willblev/SmokeyTheBarrel/(threads)

Thread 1 (2018-02-23):

Update on your smoker controller

SouthernAtHeart, 2018-02-23:
Hi, I’m wondering how this project is working out for you after 6 months. I’m working on making a similar project and was wondering if the Wemos wifi is working well for you. Thanks.

willblev, 2018-02-23:
It's working out swell! The only things I have changed were some snippets
of code to correct for some of the temperature probes which were giving low
readings, and adjusting the PID.

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

willblev, 2018-02-23:
Most likely it is not, but I will update it soon :-)

On Fri, Feb 23, 2018 at 5:22 PM, SouthernAtHeart <notifications@github.com>
wrote:

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

SouthernAtHeart, 2018-05-23:
Have you been able to tweak your code some?  Could you post your latest code with improved PID control. Thanks!

willblev, 2018-05-27:
Here's a fairly detailed explanation behind the [PID magic](https://www.controleng.com/single-article/understanding-pid-control-and-loop-tuning-fundamentals/61530560e8cf5044c7291bda7e44b655.html). As far as I understand, the algorithm will eventually sort itself out, but starting with the right parameters will get the smoker to your target temp faster (and keep it there). Let me know if you end up posting the PCB!

SouthernAtHeart, 2018-06-02:
Got my board in, but I’ve been tied up with other things.  I will send you some photos of my project when I get it done.
Later,
Charlie

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

willblev, 2018-09-10:
Hope your smoker is now up and running smoothly! I will update this repo soon to include some code which protects against undesired ATC behavior which could happen if any of the temperature probes stop working in the middle of a smoke. I'm going to close this issue, but feel free to contact me about any future questions!

Closed 2018-09-10.

Thread 2 (2018-08-15):

Fan selection

Sensornoob, 2018-08-15:
Hi mate. This looks amazing and thought I’d give it a go.

I have most of it working and ready to attach to my drum for testing/tuning. The only thing holding up the process is that I can’t manage to shut the fan off completely, which could be a large problem once on the drum.

I have tried a bunch of duty cycle values and my fan appears to run at 100% with 0 duty cycle and slowest at 255, then faster again as it increases from there up to 1000, but at no point shuts off.

Did you happen to come across this at all?
I’m assuming now that the fan I purchased can not be shut down via pwm. Would you be able to share the model number of the fan you used in you set up please?

Thanks for sharing your awesome project.

willblev, 2018-08-15:
Hi!
Glad to hear your build is going well otherwise! I did run in to the exact same problem. 4 wire fans that can be controlled via PWM have an ESC board inside them- this circuit detects the input and decides how fast the fan should go, then looks at the tachometer to see how fast it is turning. Depending on the specs of your particular fan model, if it doesn't detect an input that falls within the expected range, it may ramp up to full speed. From what I remember, my fan (a Dell KH302 harvested from an old server rack)
did the same thing. I think I got my hands on the spec sheet for this model, and found a chart that showed the relationship between input duty cycle/fan RPM.

If you're unable to dig up a specification sheet for your fan model, I can think of 2 possible solutions: 1. Use another GPIO coupled with a hefty transistor to toggle power (on/off) to the fan if you want to be sure you can really get 0 RPM. 2. Make a quick sketch that starts the fan off at 255 and increments down to 0 (printing the value to serial monitor every second) to see what the lowest possible duty cycle is for your fan before it decides to kick up to full blast.

Best of luck and let me know if you have any other questions!

Sensornoob, 2018-09-10:
Thanks for your help mate. I have it all working now. Ended up with an IRL540N to switch it off completely when target and/or pull temp is reached. I did use a logic level converter to up the current as the digital pin wasn’t sufficient to saturate the gate. It’s now running as expected during testing. I will be making a box for it sometime over the next week which will use a barrel union to connect to an existing inlet, and adding an open lid function to drop the temp by x degrees before opening the lid to help limit temp spikes. Can’t wait to get this on the drum.

willblev, 2018-09-10:
No problem! I was going to include a lid sensor to attempt to do the same thing (try to avoid temperature spikes) but in the end I prioritized finishing the project to be able to start smoking. Be sure to post your tweaks and improvements somewhere!

Sensornoob, 2018-09-10:
Will do mate. Cheers.

Closed 2018-09-10.

Thread 3 (2019-02-06):

Fan wiring

leeb81, 2019-02-06:
Hi. I'm new to Arduino and esp8266. I've build a couple of simpler projects both standalone and with blynk, but I'm struggling with the fan wiring.

I see you have used a 4 wire fan for the pwm, but cannot see where you have wired the tacho pin to or if it is wired at all.

willblev, 2019-02-06:
Hi leeb81,

No worries- I'm no expert either- I will try to help clear up the ambiguity. I meant to upload a schematic of the project when I finished, but I never got around to it... sorry!

 You're correct to guess that I don't wire the tach pin. I only tell the fan the relative speed I want via the PWM pin, and then I assume that it's spinning at the speed I asked for. If the fan stalled or burned out, I'd currently have no way of knowing.

Best of luck!

leeb81, 2019-02-06:
Thanks for the quick reply. That clears it up nicely, I can work all the rest out from the code. Now I just have to wait for the max6675s that I ordered to turn up, and I can finally sit indoors while the BBQ does its business.

Closed 2019-02-06.

Thread 4 (2020-12-29):

Electronics Schema

greghesp, 2020-12-29:
Do you have a wiring diagram/ scheme for the electronics part?
The software side is simple for me to understand, but the hardware side I'm not so sure on

willblev, 2020-12-29:
Hi @greghesp,

I originally intended to upload a diagram/schematic but I never got around to it! Unfortunately I doubt that I'll be able to upload one the repo for a while as I'm not in the same location as Smokey, but if you're interested in making your own, I'd be happy to help you figure it out.

From the code we see where the different parts are connected to the WeMos D1 mini:
```
int fanControlpin = D0;
int const thermoSOpin = D6; // pin D6  *MISO*
int const thermoSCKpin = D5;  // pin D5 *CLK*
int const probe_A_CSpin = D1;  //
int const probe_B_CSpin = D2; //
int const probe_C_CSpin = D3; //
int const probe_D_CSpin =D4; //
int const probe_E_CSpin = D7; //
```

As far as I can remember (I'm not able to open it and snap photos as previously mentioned), the thermocouples are all sharing a common connection to D6 (MISO) and D5 (CLK), then each of the thermocouples' CS pins are connected to a different pin on the WeMos. AFAIK, the fanControlpin is wired directly to the PWM input lead of the fan; the fan model I used could accept a range of voltages on this input so I didn't have to do anything fancy.

Do you already have the components?

greghesp, 2020-12-29:
I've got them similar components on order, just waiting for them to arrive.

I've got a NodeMCU rather than a D1 mini, although that should make little difference, and I've ordered some MAX31865 amplifiers. Very similar setup from what I can tell though

willblev, 2020-12-29:
As long as it's a ESP8266 based board, you should be set. Just be aware
that the pin names may vary between the D1 mini and the board you use, so
you may need to make adjustments to the code to ensure the CLK, MOSI, etc.
pins are going to the correct pins on your board.

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

greghesp, 2021-01-08:
Im running a NodeMCU, but U cant even get the MAX31865 example code to upload.  Seems when the max's are connected, it fails

willblev, 2021-01-09:
Hi again!

So if I have understood correctly, you are using this model of ESP8266-based microcontroller:
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
You can find some more details about the [different functions of each pin in the NodeMCU here ](https://www.make-it.ca/nodemcu-arduino/nodemcu-details-specifications/).

My build/code uses the [WeMos D1 mini](https://escapequotes.net/esp8266-wemos-d1-mini-pins-and-diagram/), which looks like this:
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

Both boards should be able to run the code, with minor changes such as the names of the pins in the code. You should note that _the name of the pin printed on the board is not always the name the Arduino IDE assigns to the pin_. You may need to map out on paper the allocation of each pin to each component, as you may have conflicts (e.g. you run out of PWM capable GPIOs to run the blower fan if you use the wrong one of the two possible MOSI pins).

I opened up my temperature controller to try and figure out how I have everything wired, but unfortunately I was quite generous with the hot glue, so I couldn't get any good pictures. What I CAN see, is that the MAX31865 share some common connections (SCK, MISO, MOSI) like is shown [here](https://forum.arduino.cc/index.php?topic=461755.0):
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

I would recommend that you first try connecting just one thermocouple and get the example code running with that, then try scaling up piece by piece. Hope this helps you to move forward!

greghesp, 2021-01-09:
Sorted! I had to strip back your code and build it up from scratch selecting what I needed using the MAX31865 library, but I've managed to get the temperatures to read out from both probes now :)

In your `readTempSensors` function, what's the reason for the calculation to set the temperature?

` foodTemperature_Last = (2 * foodTemperature_Last + foodTemperature)/3;`

Wouldn't it just be ` foodTemperature_Last = foodTemperature`

willblev, 2021-01-09:
Glad to hear that you got it working! You can change the aforementioned line if you want; I think my intention was to smooth the values to avoid turning off everything prematurely due to one high reading.

greghesp, 2021-01-09:
Out of interest, how are you powering it and doing the 12v to 3v?  I've got some buck converters from my 3d printer, but they seem a little big and excessive for this xD

willblev, 2021-01-09:
I believe I used a cheap (~$1) DC-DC step down voltage regulator, but I
think I stepped down 12v to 5v as my microcontroller could take that as
input. If you check what voltage and current your MAX modules need, you
might only need to use one converter to power the MCU and modules.

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

greghesp, 2021-01-10:
Seems the NodeMCU outputs 3v, so have bought a cheap 3v to 12v setup

willblev, 2021-01-10:
Long story short, I am afraid that taking the 3v output of your NodeMCU and
then converting it up to 12v isn't going to be enough to power your fan :(

You need to consider the load demands such as voltage (Volts) and current
(Amps) as well as the duty cycle needs of your components. A decently sized
blower fan @ 12v will need much more than 1A, and you'll be running it for
up to 15h at a time.

The NodeMCU has an onboard voltage regulator (usually an AMS1117) which
typically takes an input voltage of 5-12v and delivers ~1.5A @ 3.3v. If you
want to power a small peripheral module that can run on 3.3v and only uses
a couple hundred mA (1000mA = 1A), this onboard regulator is sufficient.
But if you need to run something bigger, like a decently sized blower fan @
12v, you'll need much more. We can use the formula below to see how much
current we'd get out from converting from 1.5A @ 3.3v to 12v (assuming our
step-up voltage regulator has an efficiency of 80%, which I just made up,
but just to illustrate my point):

P = U * I

Where P is power in Watts, U is voltage in Volts, and I is current in Amps

Our input is 3.3v @1.5A, and our output is 12v.
3.3v * 1.5A = 4.95 Watts
Since we said we'd lose 20% of the power in the step-up conversion, 4.95 *
0.8 = 3.96 Watts
3.96 Watts / 12v = 0.33A or 330mA

Many 12v fans draw 2-4A at their top speed, so we're nowhere close to being
able to power the fan at full blast using the step-up voltage converter. If
you can, I would power your whole project with a hefty ~4A @12v power
supply, then use a step-down DC-DC converter which can give you ≥1A @5v.
The specs of the onboard NodeMCU voltage regulator looks like it can only
take up to 10v, so you would risk frying it if you didn't step down the
voltage first. 1A @5v should be enough to power the NodeMCU, as well as the
MAX modules (which can run on 3-5v and draw under 50mA each if memory
serves). Double check for yourself before accidentally frying one though ;)

Hope this helps!
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

greghesp, 2021-01-10:
Makes sense, its a 12v 3a fan.  Ideally I'd like to power this via USB from a power bank (Micro, Mini, USB C) but I cant seem to find anything to handle this

willblev, 2021-01-10:
Something like this may work.
https://m.aliexpress.com/item/4000289210562.html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

It's a power bank which uses 6x 18650 lipo cells (sold separately) and is
able to deliver plenty of current over a wide range of voltages (including
12v). I have used it to power my laptop @19v. Decent 18650 cells can often
be recovered from old laptop batteries if you can source those easily- just
be careful and watch a few tutorials so you don't blow anything up!

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

Thread 5 (2021-05-22):

Temp Sensor Value

bjarne007, 2021-05-22:
Hi
I love you Smokey barrel project
i have a issue with the temp sensor value
i get this value 2147483647haw you a ide what a du wrong

10:40:22.819 -> 95	|125	|2147483647	|0	|0	|0	|0

willblev, 2021-05-23:
Hi!
I think that this impossible temperature reading suggests that there is a
loose connection on the probe, or that the thermocouple wire is bent in
some bad way. I am sorry I can't give a better guess without more
information.

Good luck!

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
