willblev/SmokeyTheBarrel/(commit log)

2017-04-09 Create Wills_UDS_ATC.ino
    added Arduino sketch
2017-04-11 Update Wills_UDS_ATC.ino
    added PID functionality and updated tempBelow
